tom91136/nixieclock/docs/IN4.pdf

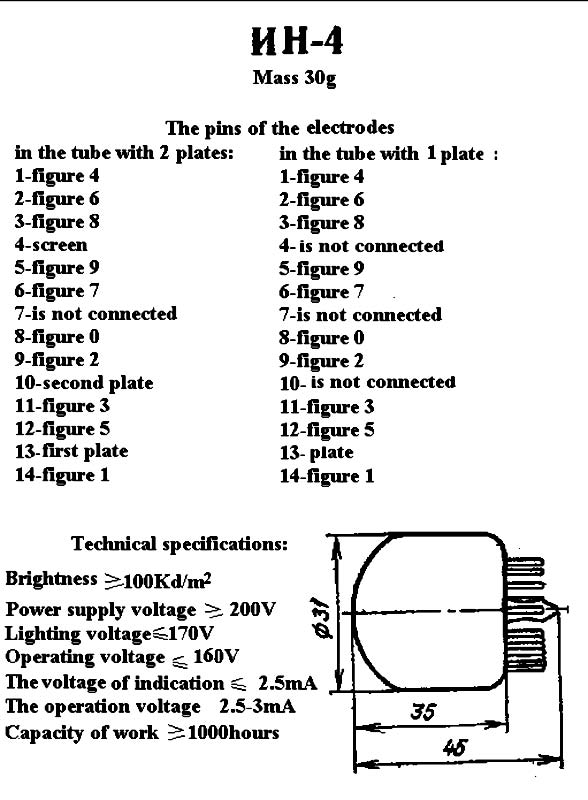
[picture p15: page 1]
