tom91136/nixieclock/docs/sn74141.pdf

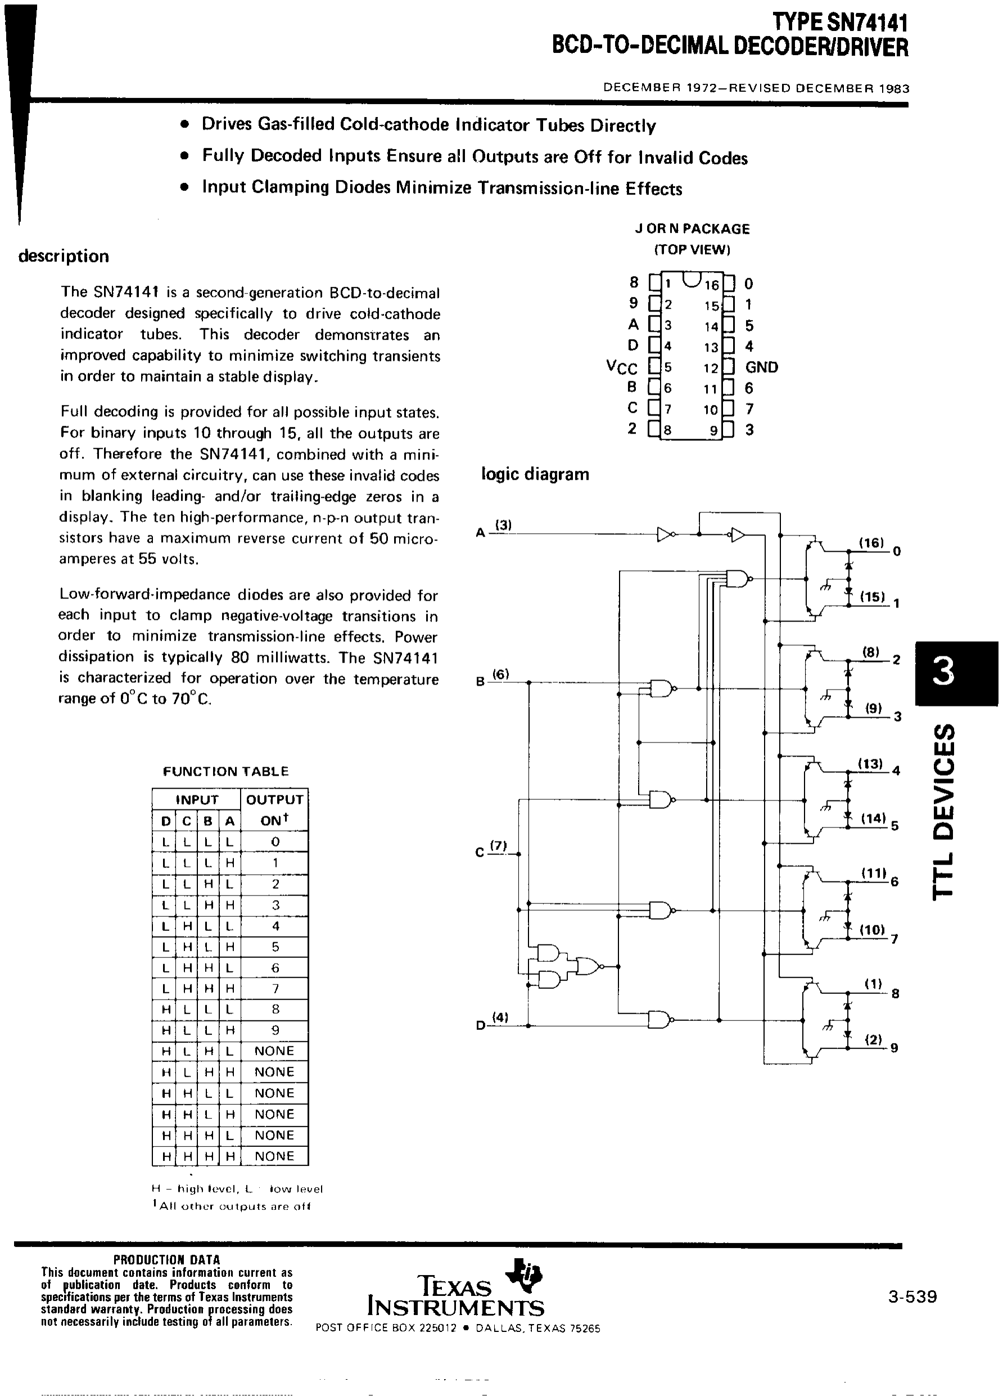
[picture p16: page 1]
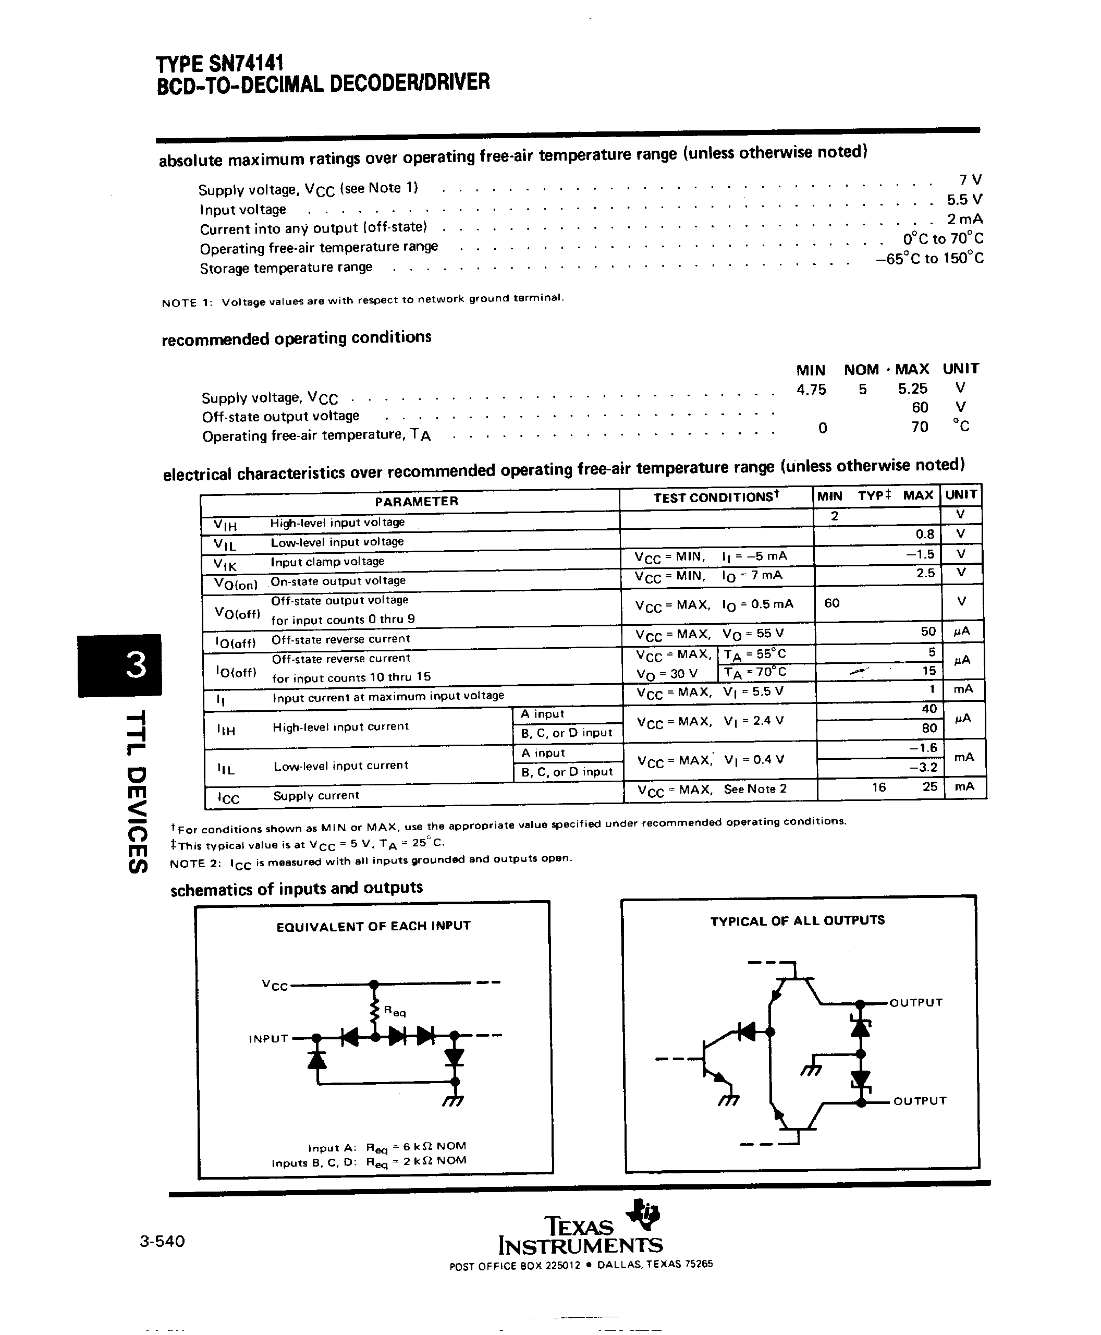
[picture p17: page 2]
