tom91136/nixieclock/(list of files, drawings)

Other design files:
src/controller.dch
src/controller.dip
src/display.dch
src/display.dip
src/hv_power.dch
src/hv_power.dip
