tom91136/nixieclock/photos/2.jpg

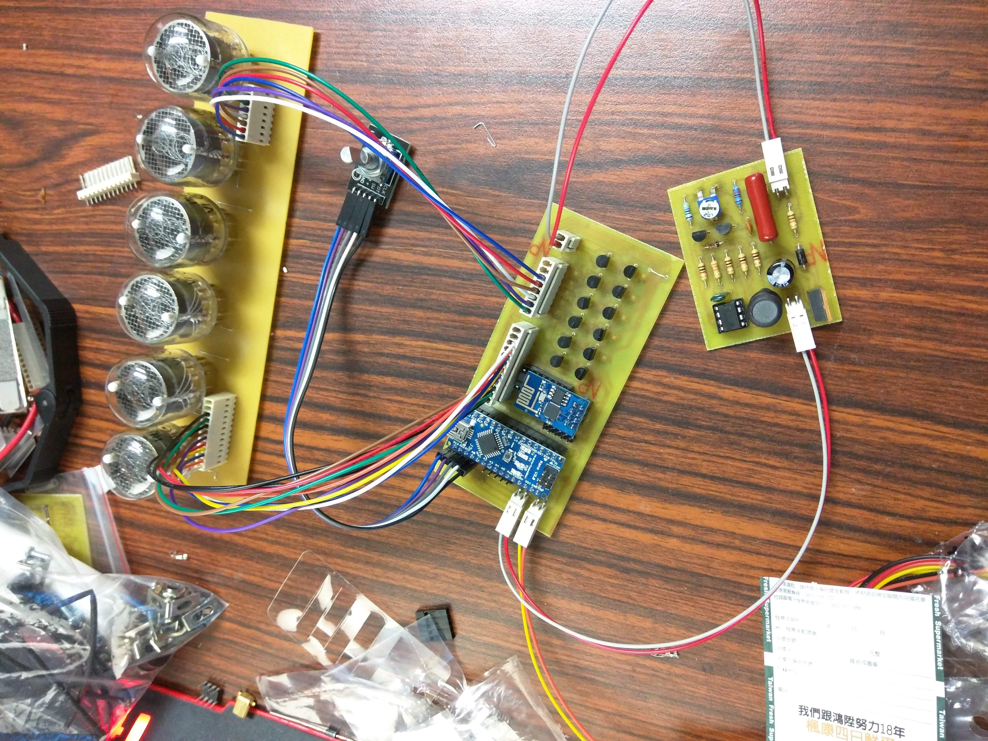
[picture p2: photos/2.jpg]
photos/2.jpg
